afiskon/hbr-3b/images/hbr-3b-transceiver.jpg

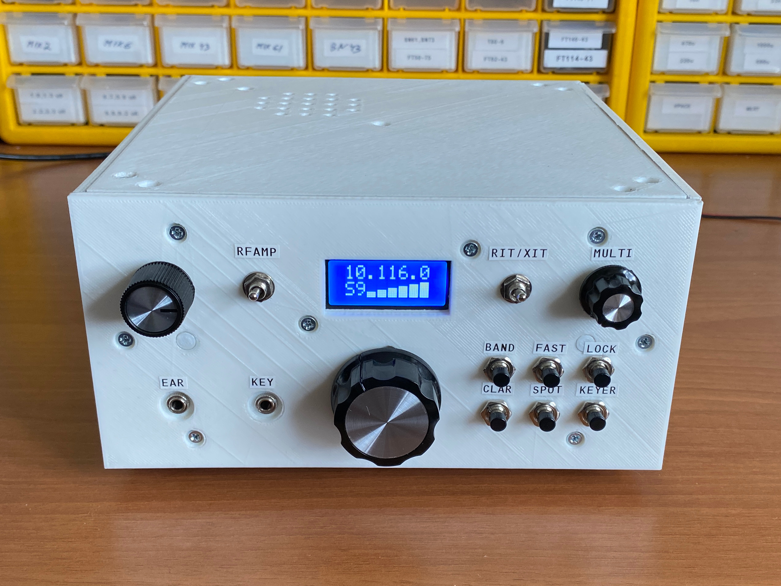
images/hbr-3b-transceiver.jpg
