afiskon/hbr-3b/README.md

# HBR/3B

QRP CW Transceiver

* Covers 30, 17, and 12 meters
* Easily modifiable for other 3 bands or [all 8 HF bands](https://github.com/afiskon/hbr-8b)
* Classical single IF superheterodyne design
* Free of spurious signals!
* Simple but effective AGC
* Supports RIT and XIT
* 10-30 WPM Elekey-B type keyer + straight key mode
* Keyer settings are saved in EEPROM
* ~5W class C power amplifier
* Has a S-meter and a SWR meter
* Open-source firmware, schematic and 3D-printable enclosure

Links

* Article (in Russian): https://eax.me/2022/2022-09-05-hbr-3b-transceiver.html
* Demo: https://www.youtube.com/watch?v=xab1Q_SXZec
