afiskon/hbr-3b/firmware/si5351/README.md

# stm32-si5351

HAL-based Si5351 driver for STM32.

Main respository: https://github.com/afiskon/stm32-si5351
