afiskon/hbr-3b/images/filters/bpf-12m.png

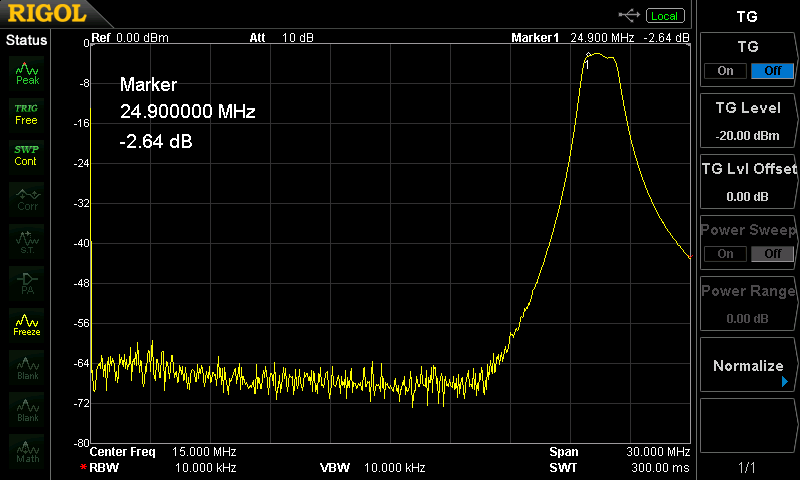
images/filters/bpf-12m.png
