afiskon/hbr-3b/images/filters/bpf-17m.png

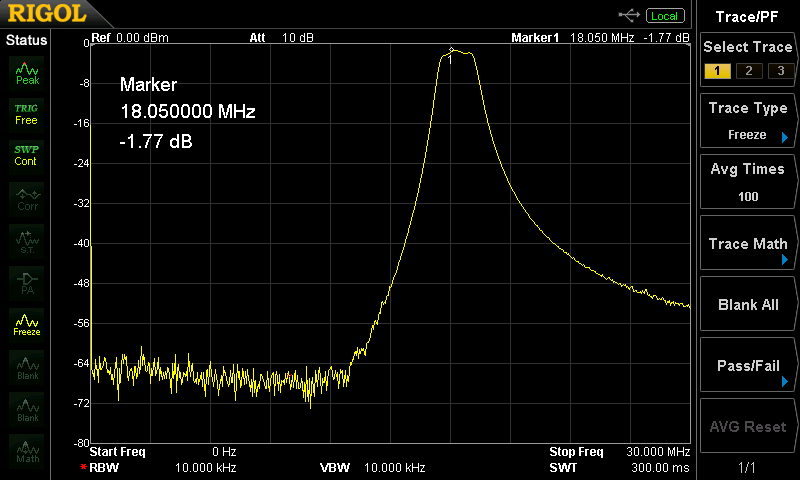
images/filters/bpf-17m.png
