afiskon/hbr-3b/images/filters/bpf-30m.png

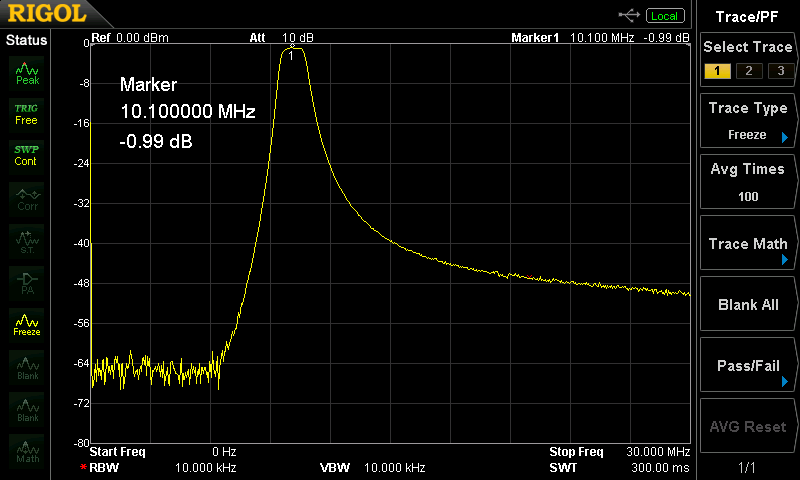
images/filters/bpf-30m.png
