afiskon/hbr-3b/images/filters/lpf-9mhz.png

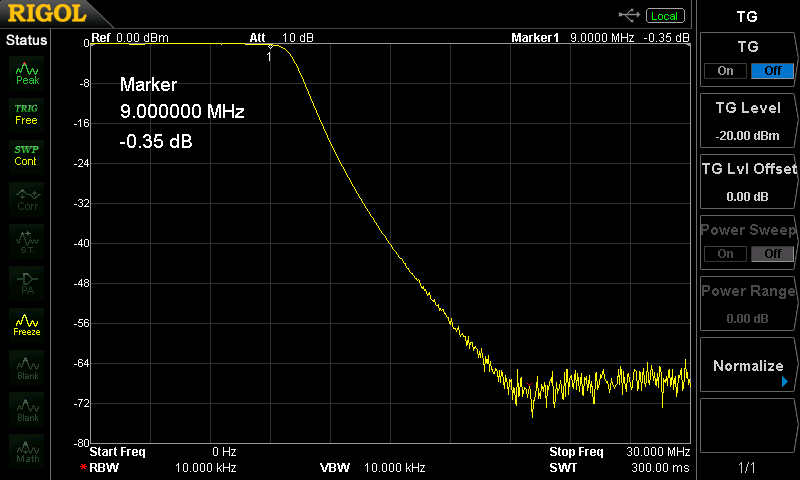
images/filters/lpf-9mhz.png
