afiskon/hbr-3b/images/filters/lpf-12m.png

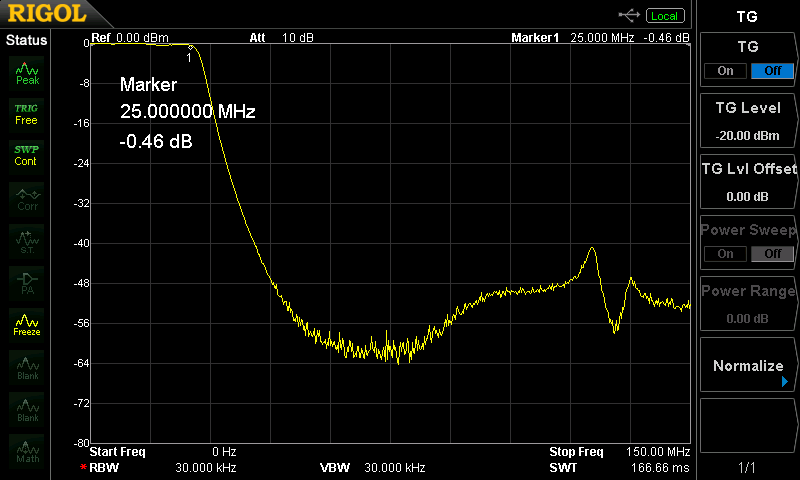
images/filters/lpf-12m.png
