afiskon/hbr-3b/images/filters/lpf-17m.png

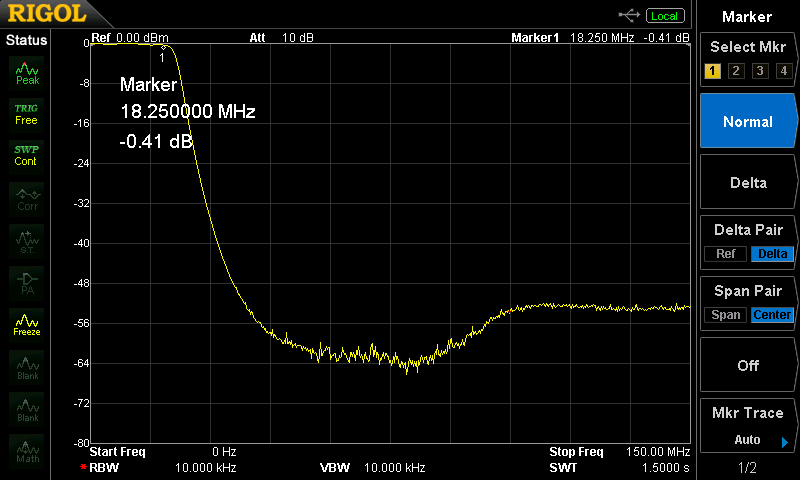
images/filters/lpf-17m.png
