afiskon/hbr-3b/images/filters/lpf-30m.png

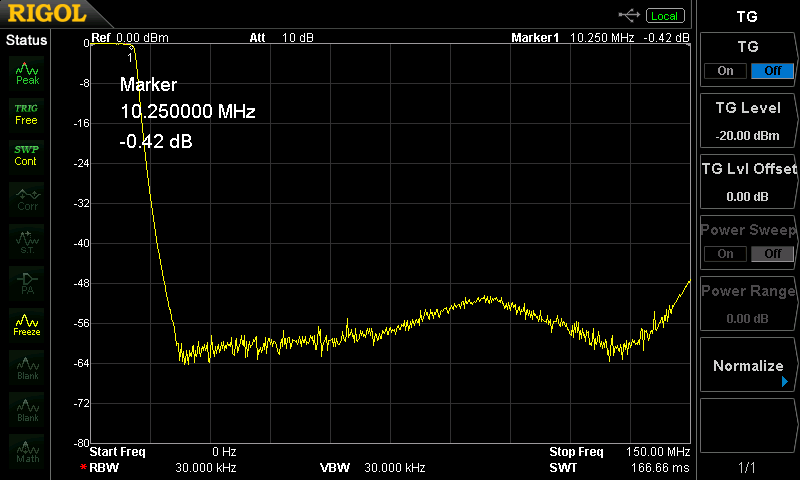
images/filters/lpf-30m.png
