afiskon/hbr-3b/images/si5351-vs-ad9850/ad9850-block-diagram.png

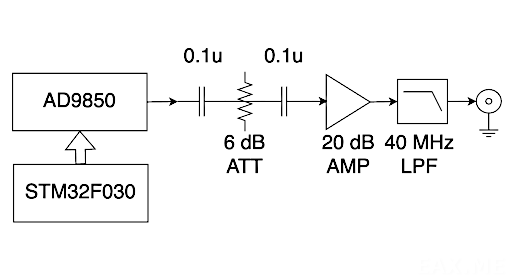
images/si5351-vs-ad9850/ad9850-block-diagram.png
