afiskon/hbr-3b/images/si5351-vs-ad9850/si5351-spectrum.png

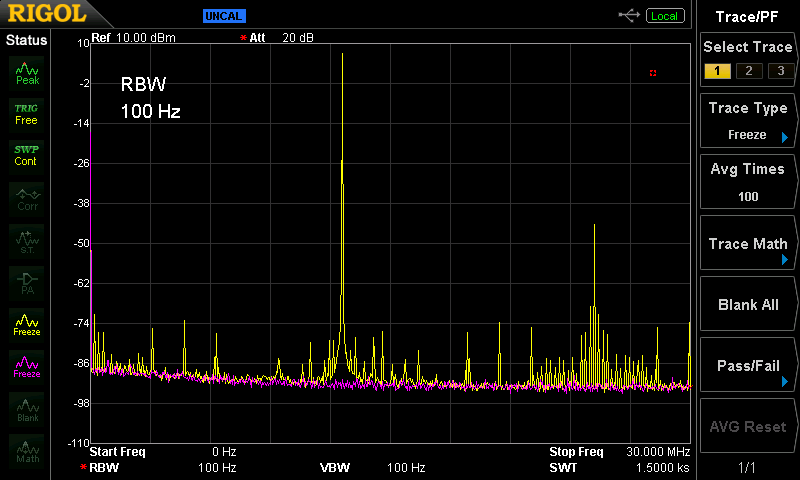
images/si5351-vs-ad9850/si5351-spectrum.png
