afiskon/hbr-3b/images/signal/signal-12m.png

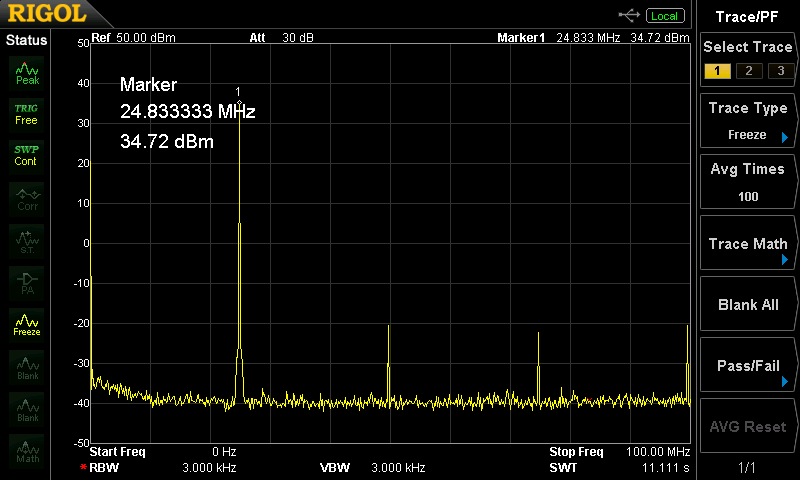
images/signal/signal-12m.png
