afiskon/hbr-3b/images/signal/signal-17m.png

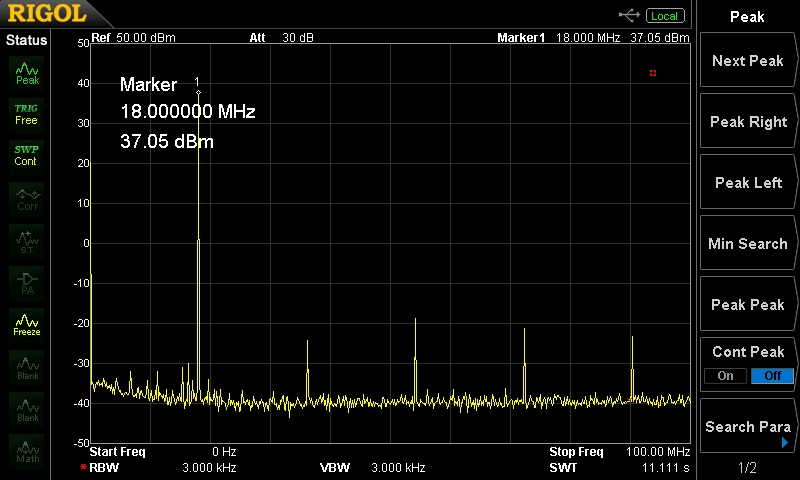
images/signal/signal-17m.png
