afiskon/hbr-3b/images/signal/signal-30m.png

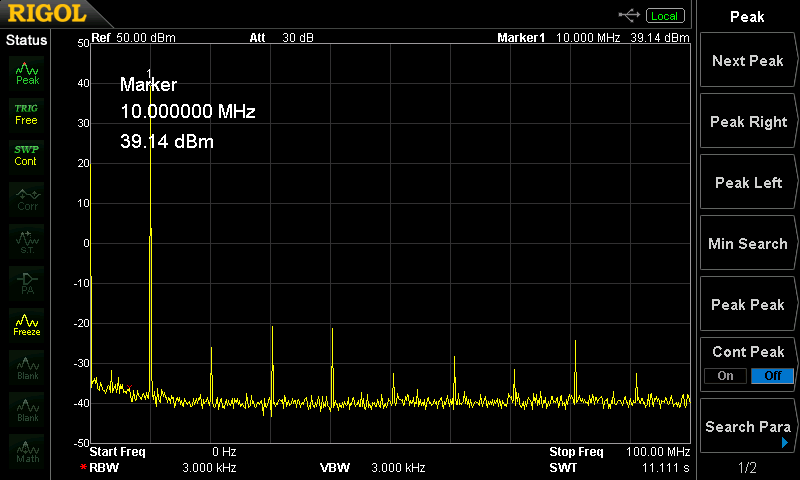
images/signal/signal-30m.png
