afiskon/hbr-3b/enclosure/large-angle.stl

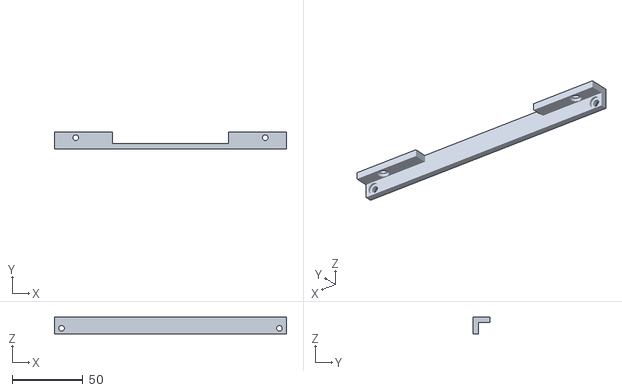
[picture p15: CAD file, 2022-07-16]
enclosure/large-angle.stl
164.0 x 12.0 x 12.0
