afiskon/hbr-3b/enclosure/top.stl

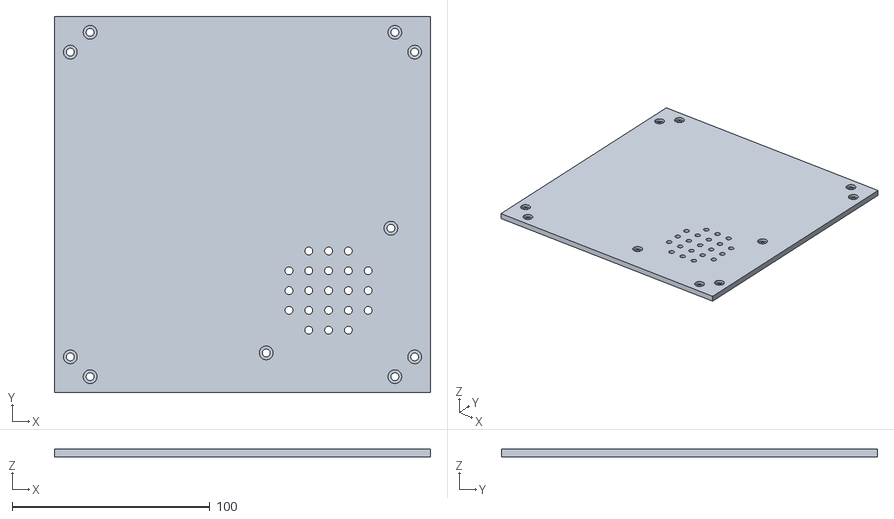
[picture p16: CAD file, 2022-07-16]
enclosure/top.stl
190.0 x 190.0 x 4.00
