afiskon/hbr-3b/enclosure/small-angle.stl

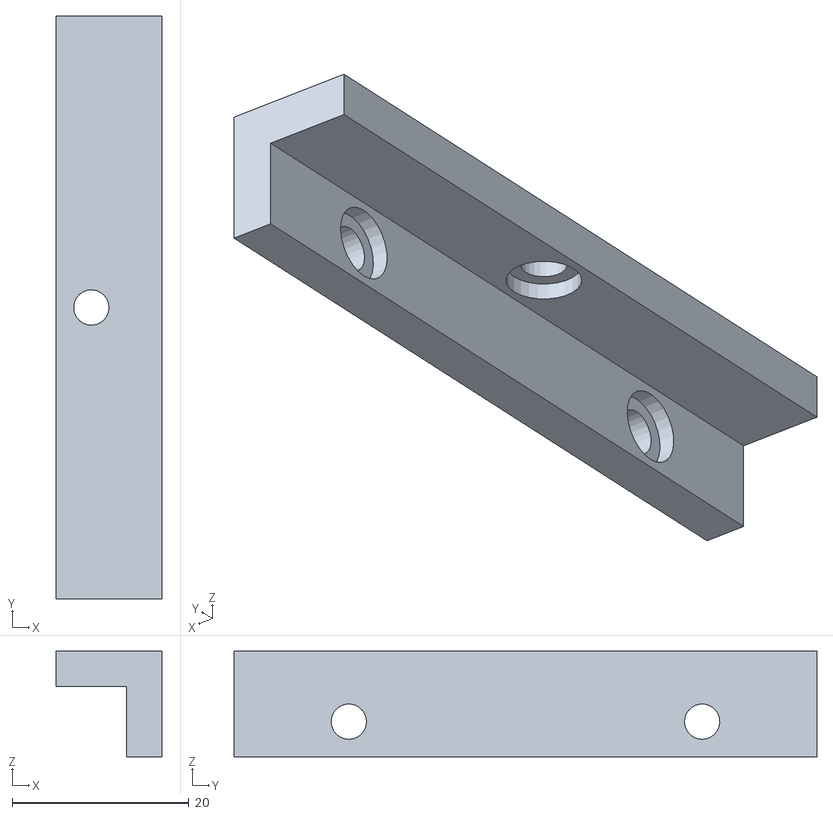
[picture p17: CAD file, 2022-07-16]
enclosure/small-angle.stl
12.0 x 66.0 x 12.0
