afiskon/hbr-3b/enclosure/back.stl

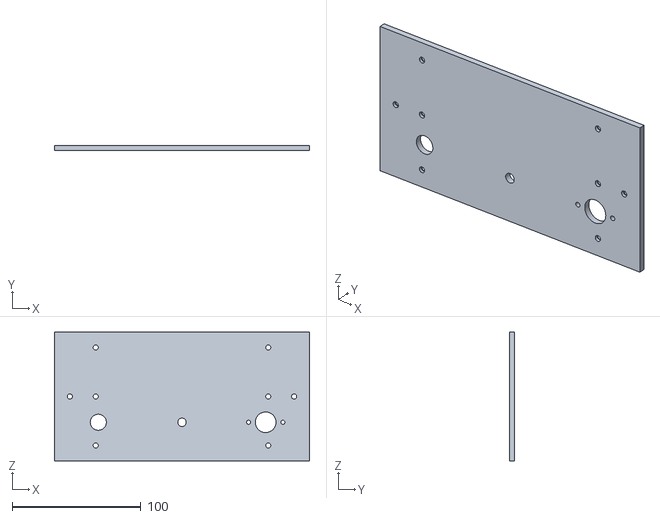
[picture p18: CAD file, 2022-07-16]
enclosure/back.stl
198.0 x 4.00 x 100.0
