afiskon/hbr-3b/enclosure/front.stl

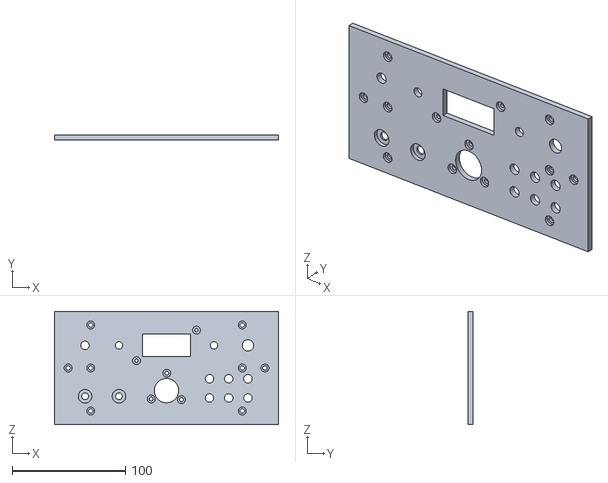
[picture p19: CAD file, 2022-07-16]
enclosure/front.stl
198.0 x 4.00 x 100.0
