afiskon/hbr-3b/enclosure/side.stl

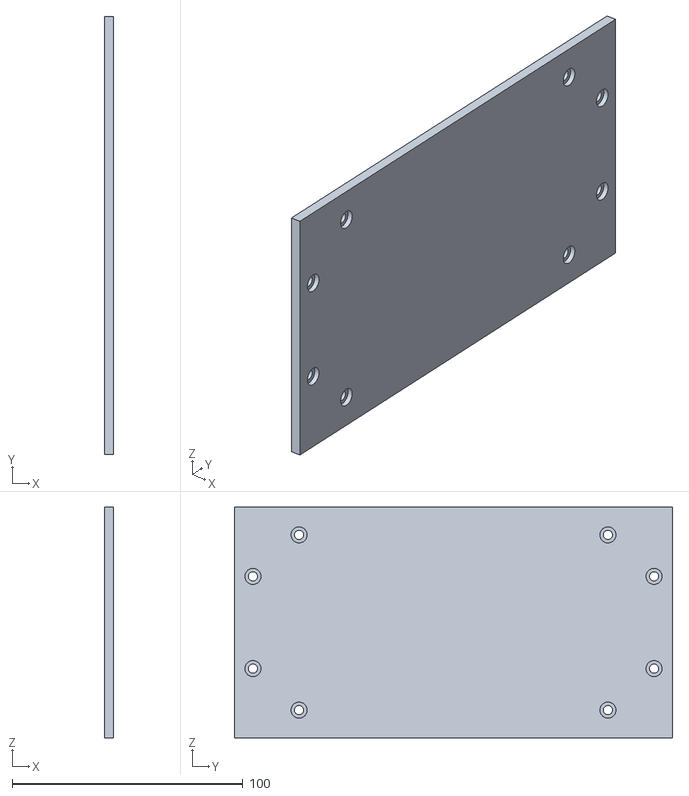
[picture p20: CAD file, 2022-07-16]
enclosure/side.stl
4.00 x 190.0 x 100.0
