afiskon/hbr-3b/enclosure/screw-cap.stl

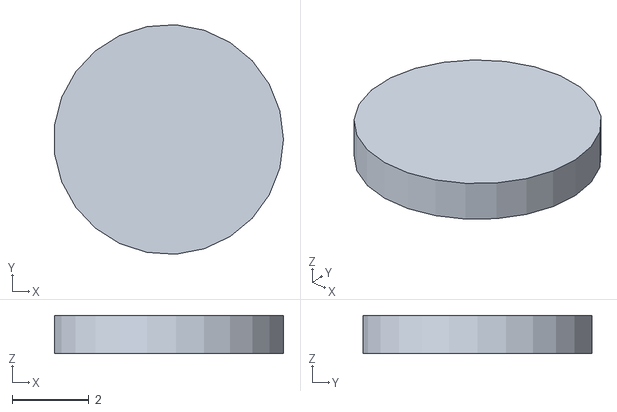
[picture p21: CAD file, 2022-07-16]
enclosure/screw-cap.stl
5.98 x 5.99 x 1.00
