afiskon/hbr-3b/(list of files, cad)

Other CAD files:
enclosure/bottom.stl
enclosure/enclosure.scad
enclosure/screw-cap.scad
