afiskon/hbr-3b/schematic/hbr-3b-schematic.pdf

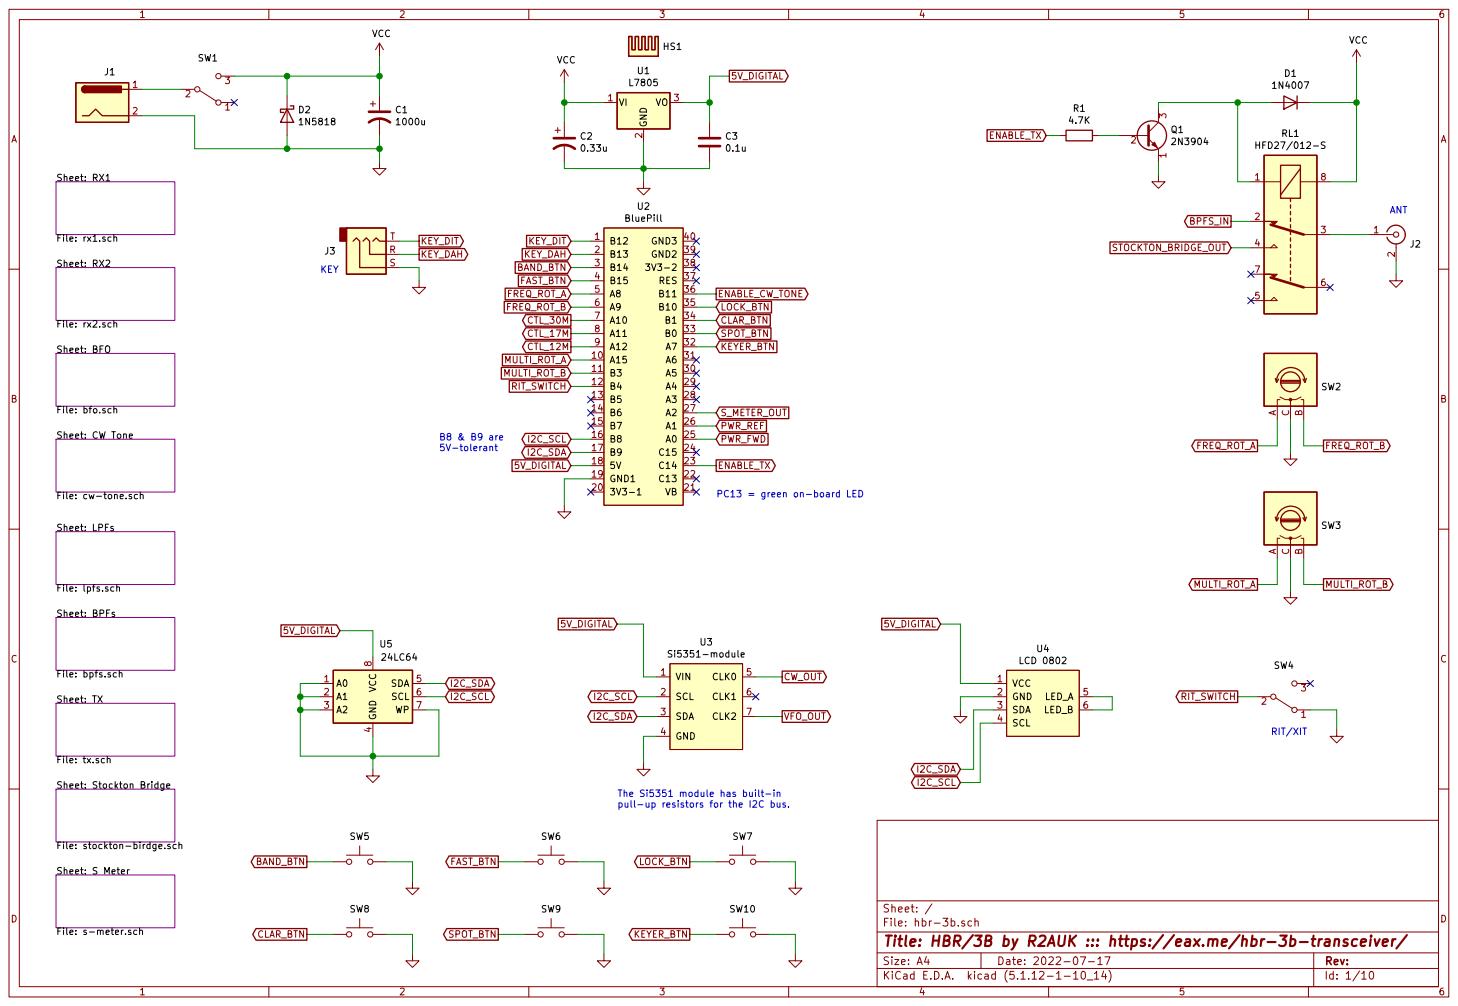
[picture p22: page 1]

Sheet: RX1 File: rx1.sch Sheet: RX2 File: rx2.sch Sheet: BFO

RIT/XIT B8 & B9 are 5V-tolerant KEY

File: bfo.sch Sheet: CW Tone File: cw-tone.sch Sheet: TX

PC13 = green on-board LED

Id: 1/10 Title: HBR/3B by R2AUK ::: https://eax.me/hbr-3b-transceiver/ File: hbr-3b.sch Sheet: / Sheet: LPFs File: lpfs.sch Sheet: BPFs File: bpfs.sch

4 SDA 5 SCL 6 WP 7 VCC

File: tx.sch Sheet: Stockton Bridge

The Si5351 module has built-in
pull-up resistors for the I2C bus.

File: stockton-birdge.sch Sheet: S Meter File: s-meter.sch

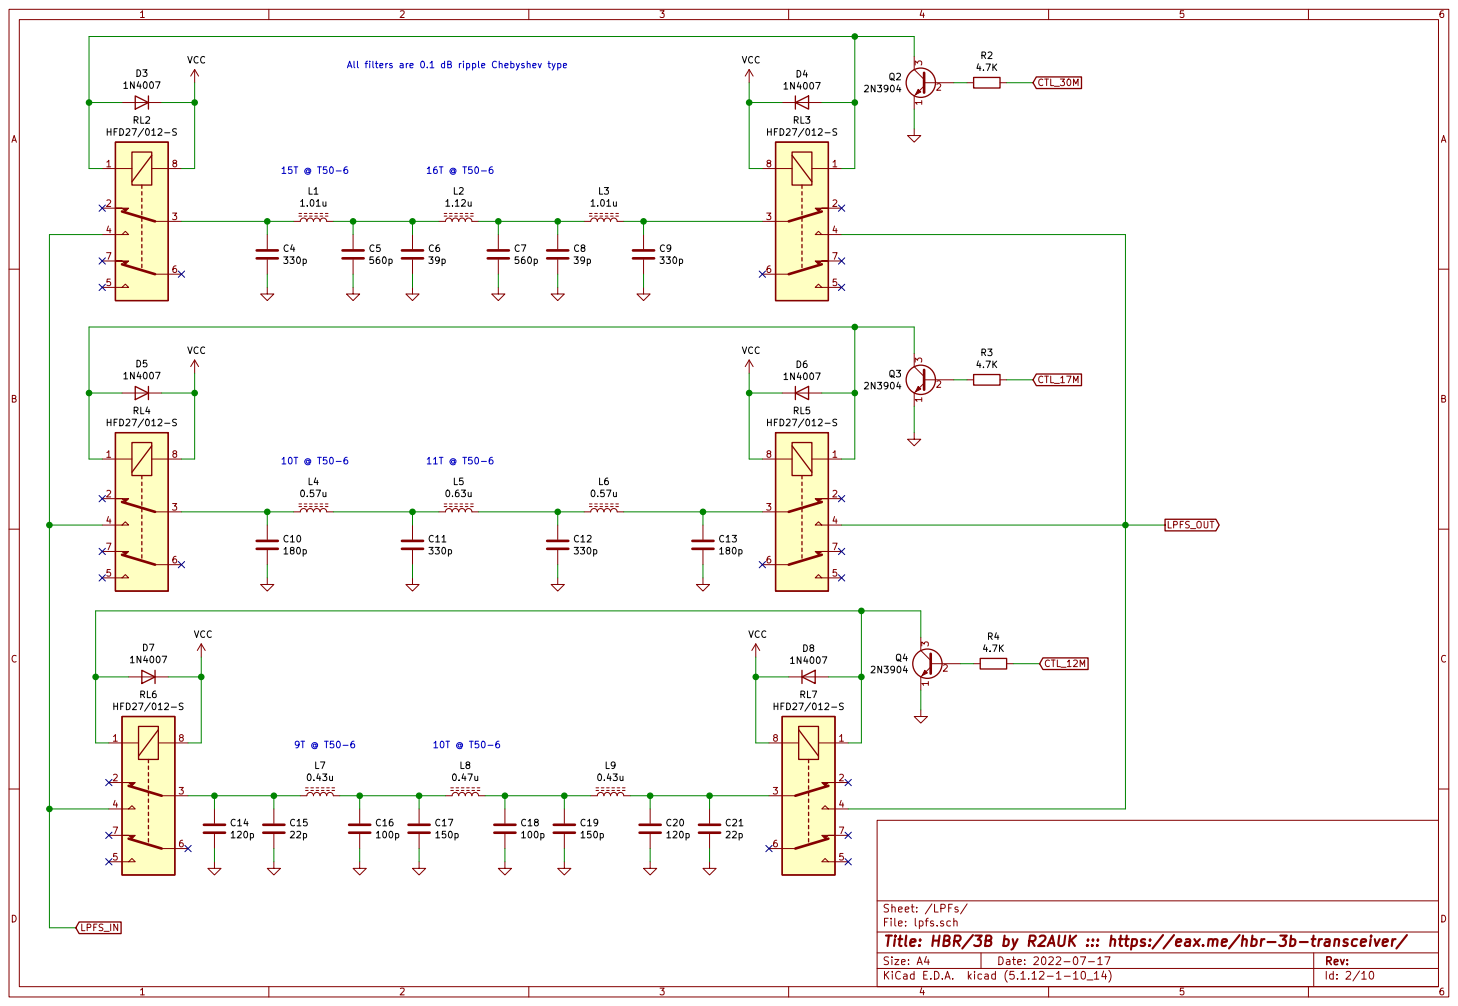
[picture p23: page 2]

All filters are 0.1 dB ripple Chebyshev type

File: lpfs.sch Sheet: /LPFs/ 1

Id: 2/10 Title: HBR/3B by R2AUK ::: https://eax.me/hbr-3b-transceiver/

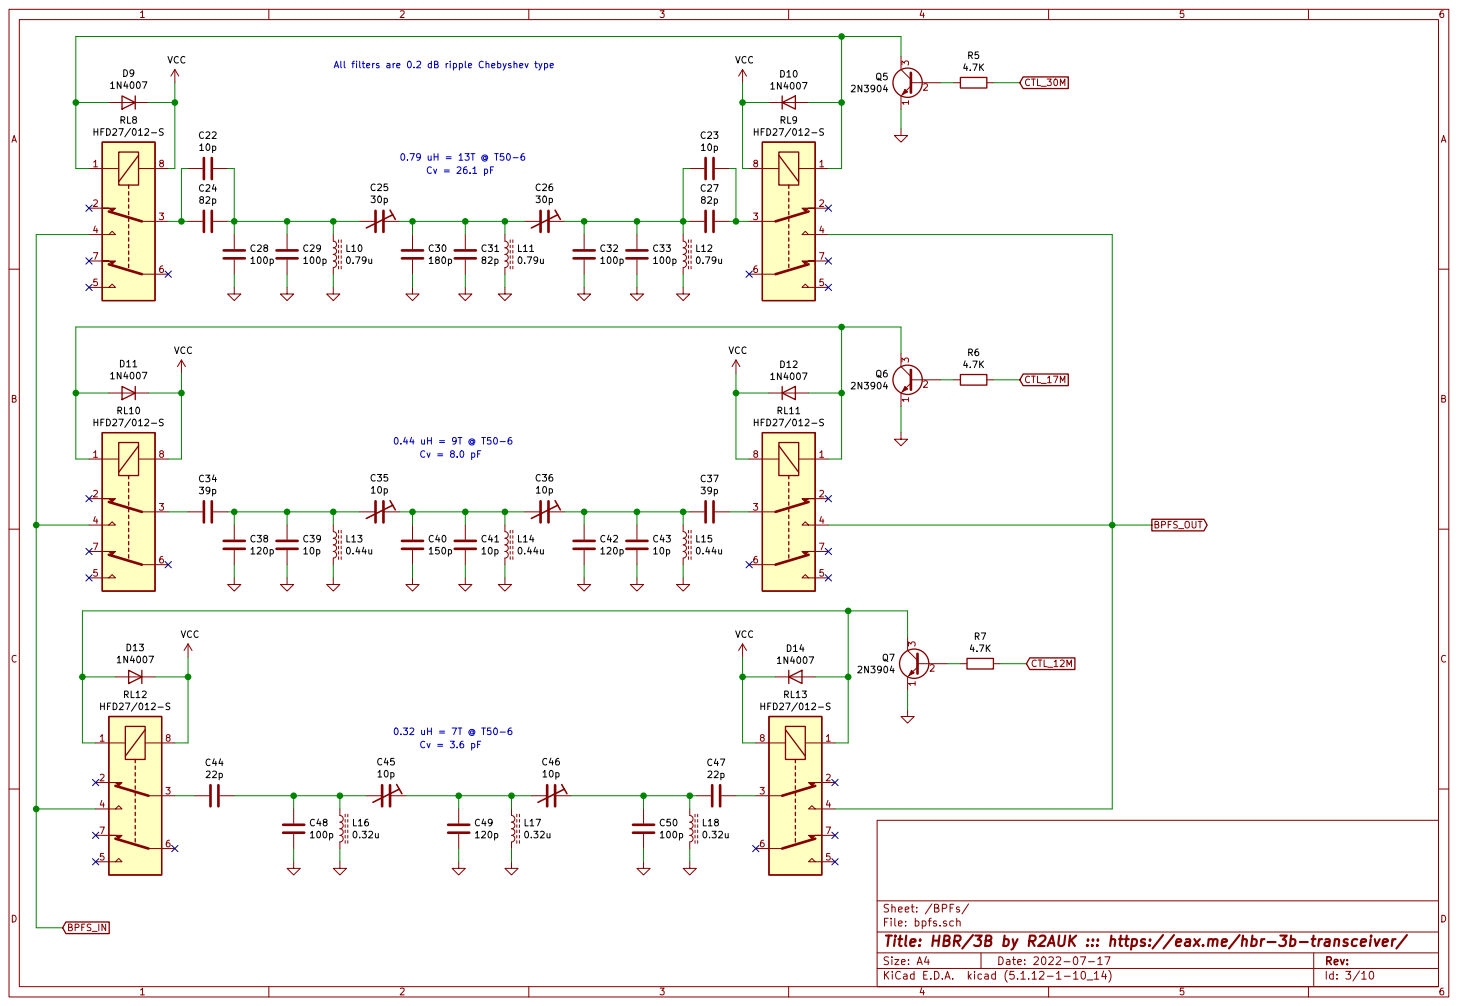
[picture p24: page 3]

0.44 uH = 9T @ T50-6 All filters are 0.2 dB ripple Chebyshev type

File: bpfs.sch Sheet: /BPFs/ 1

Id: 3/10 Title: HBR/3B by R2AUK ::: https://eax.me/hbr-3b-transceiver/

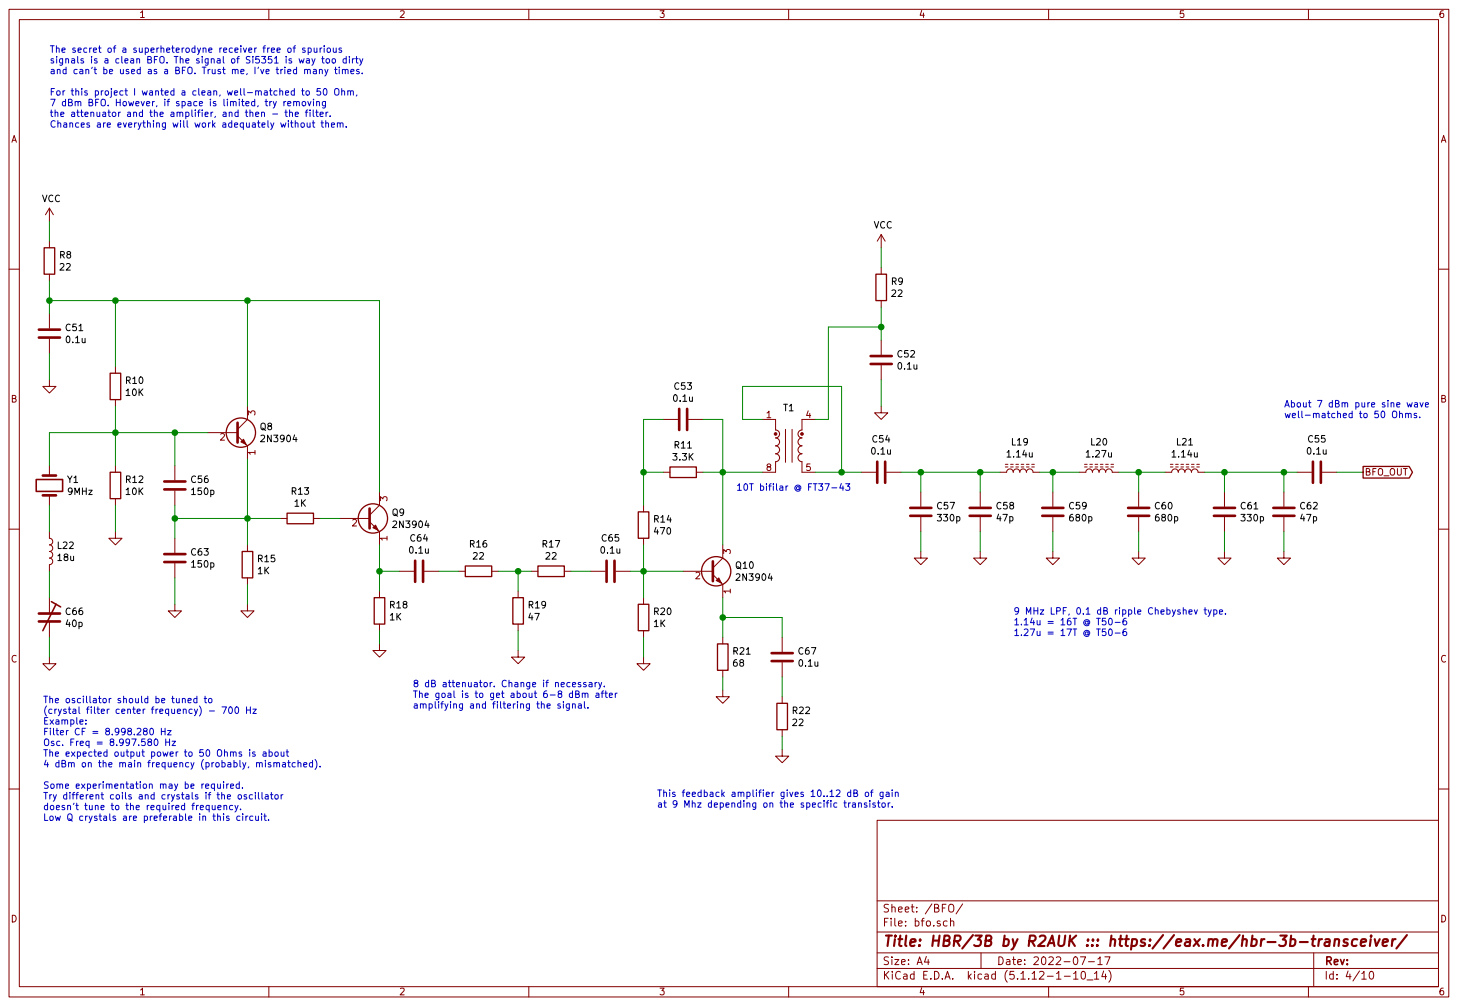
[picture p25: page 4]

signals is a clean BFO. The signal of Si5351 is way too dirty
and cant be used as a BFO. Trust me, Ive tried many times.

For this project I wanted a clean, well-matched to 50 Ohm,
7 dBm BFO. However, if space is limited, try removing
the attenuator and the amplifier, and then - the filter.
Chances are everything will work adequately without them.

10T bifilar @ FT37-43 This feedback amplifier gives 10..12 dB of gain

9 MHz LPF, 0.1 dB ripple Chebyshev type. 1.14u = 16T @ T50-6

8 dB attenuator. Change if necessary.
The goal is to get about 6-8 dBm after
amplifying and filtering the signal.

at 9 Mhz depending on the specific transistor. The oscillator should be tuned to
(crystal filter center frequency) - 700 Hz
Example: Filter CF = 8.998.280 Hz Osc. Freq = 8.997.580 Hz

The expected output power to 50 Ohms is about
4 dBm on the main frequency (probably, mismatched).

Some experimentation may be required.
Try different coils and crystals if the oscillator
doesnt tune to the required frequency.
Low Q crystals are preferable in this circuit.

Id: 4/10 Title: HBR/3B by R2AUK ::: https://eax.me/hbr-3b-transceiver/ File: bfo.sch Sheet: /BFO/

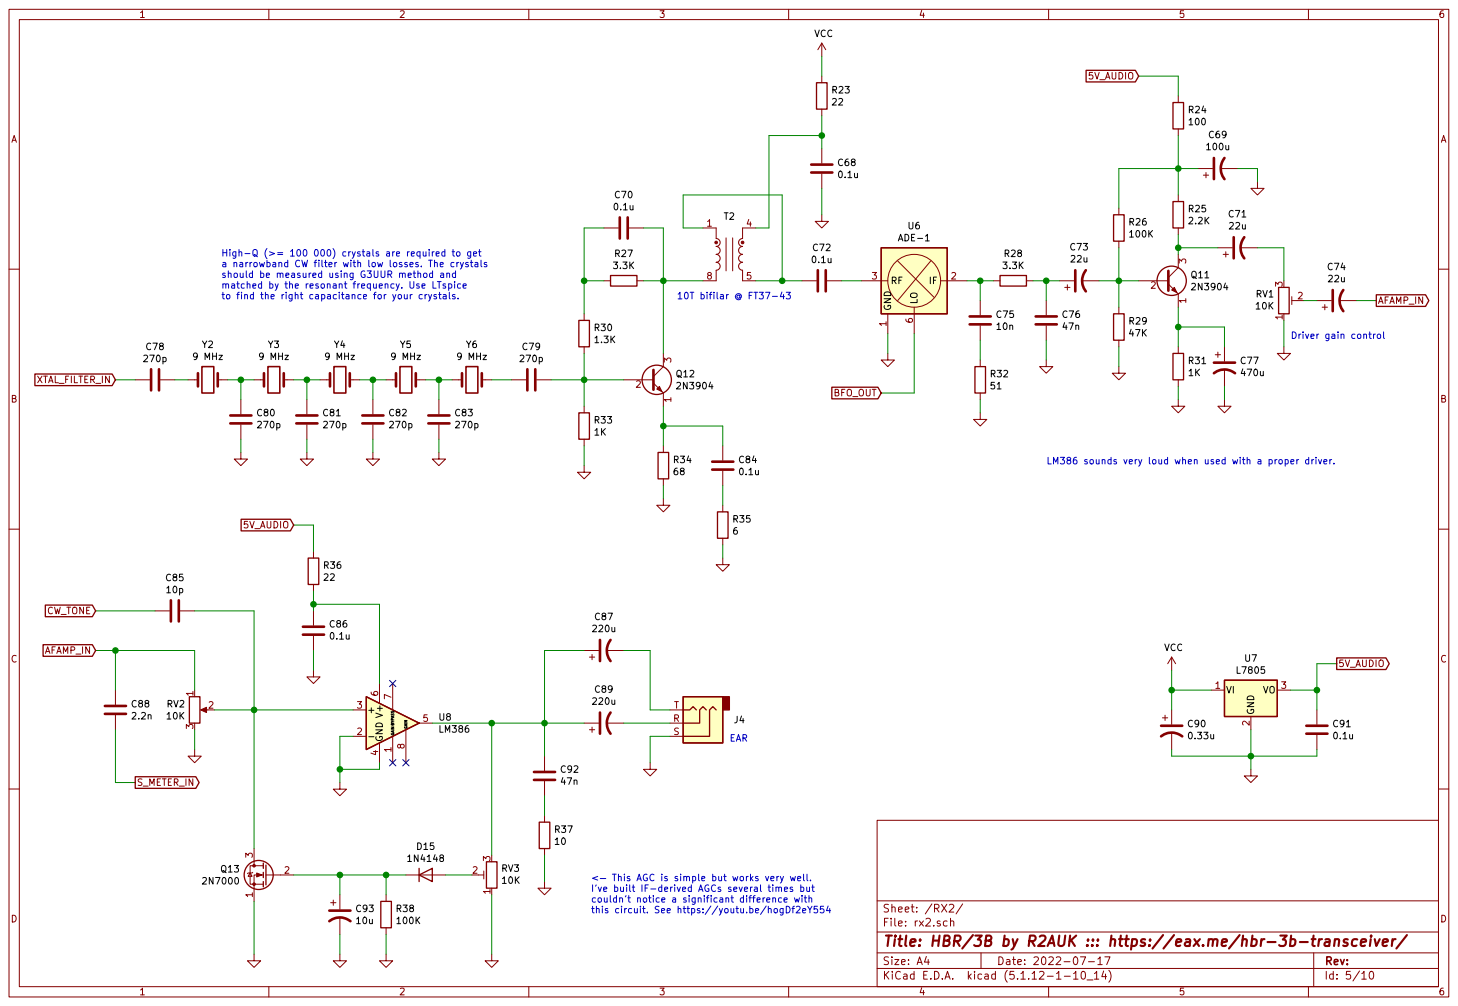
[picture p26: page 5]

High-Q (>= 100 000) crystals are required to get
a narrowband CW filter with low losses. The crystals
should be measured using G3UUR method and
matched by the resonant frequency. Use LTspice

LM386 sounds very loud when used with a proper driver.

< This AGC is simple but works very well.
Ive built IF-derived AGCs several times but couldnt notice a significant difference with

Id: 5/10 Title: HBR/3B by R2AUK ::: https://eax.me/hbr-3b-transceiver/ File: rx2.sch Sheet: /RX2/

this circuit. See https://youtu.be/hogDf2eY554

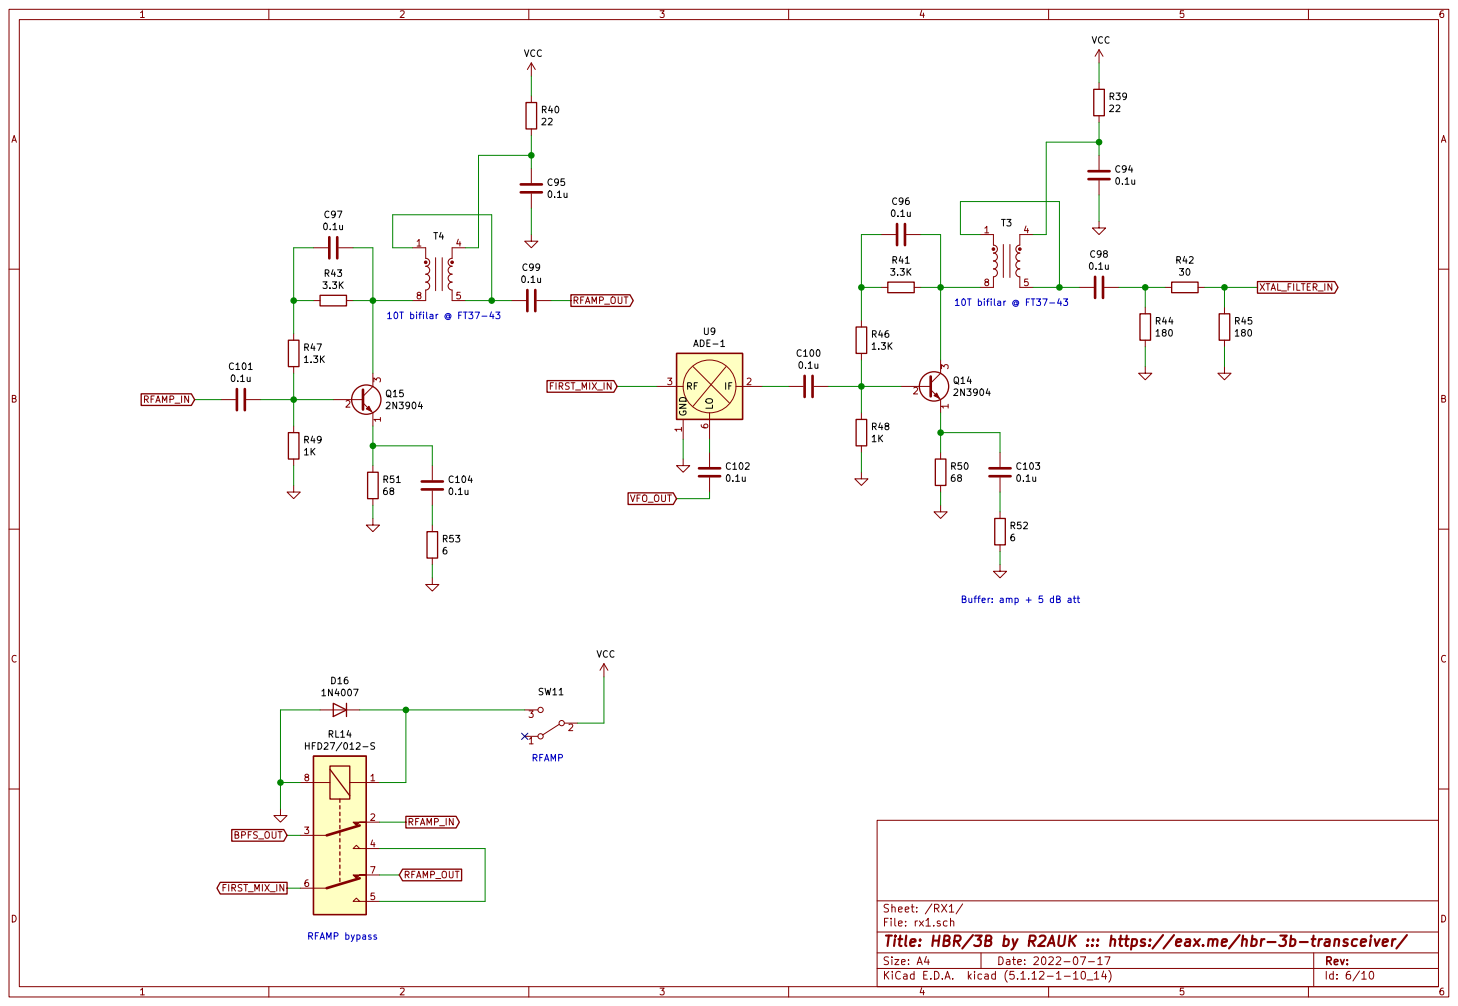
[picture p27: page 6]

Buffer: amp + 5 dB att RFAMP

Id: 6/10 Title: HBR/3B by R2AUK ::: https://eax.me/hbr-3b-transceiver/ File: rx1.sch Sheet: /RX1/

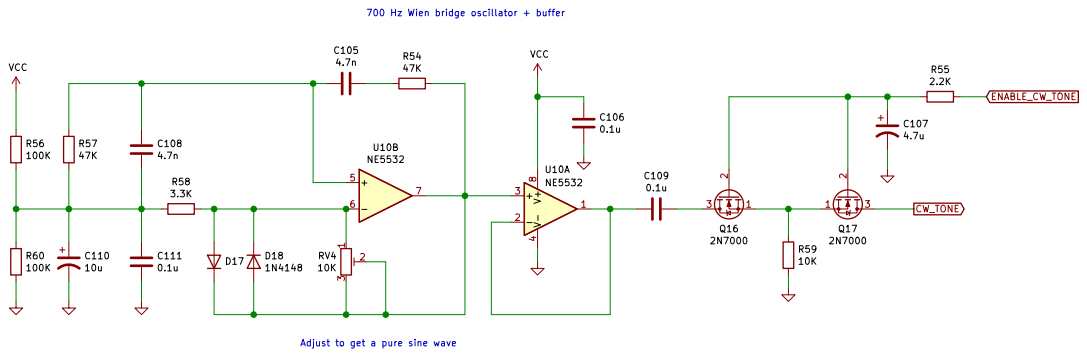
[picture p28: page 7]

700 Hz Wien bridge oscillator + buffer

Adjust to get a pure sine wave

Id: 7/10 Title: HBR/3B by R2AUK ::: https://eax.me/hbr-3b-transceiver/ File: cw-tone.sch Sheet: /CW Tone/

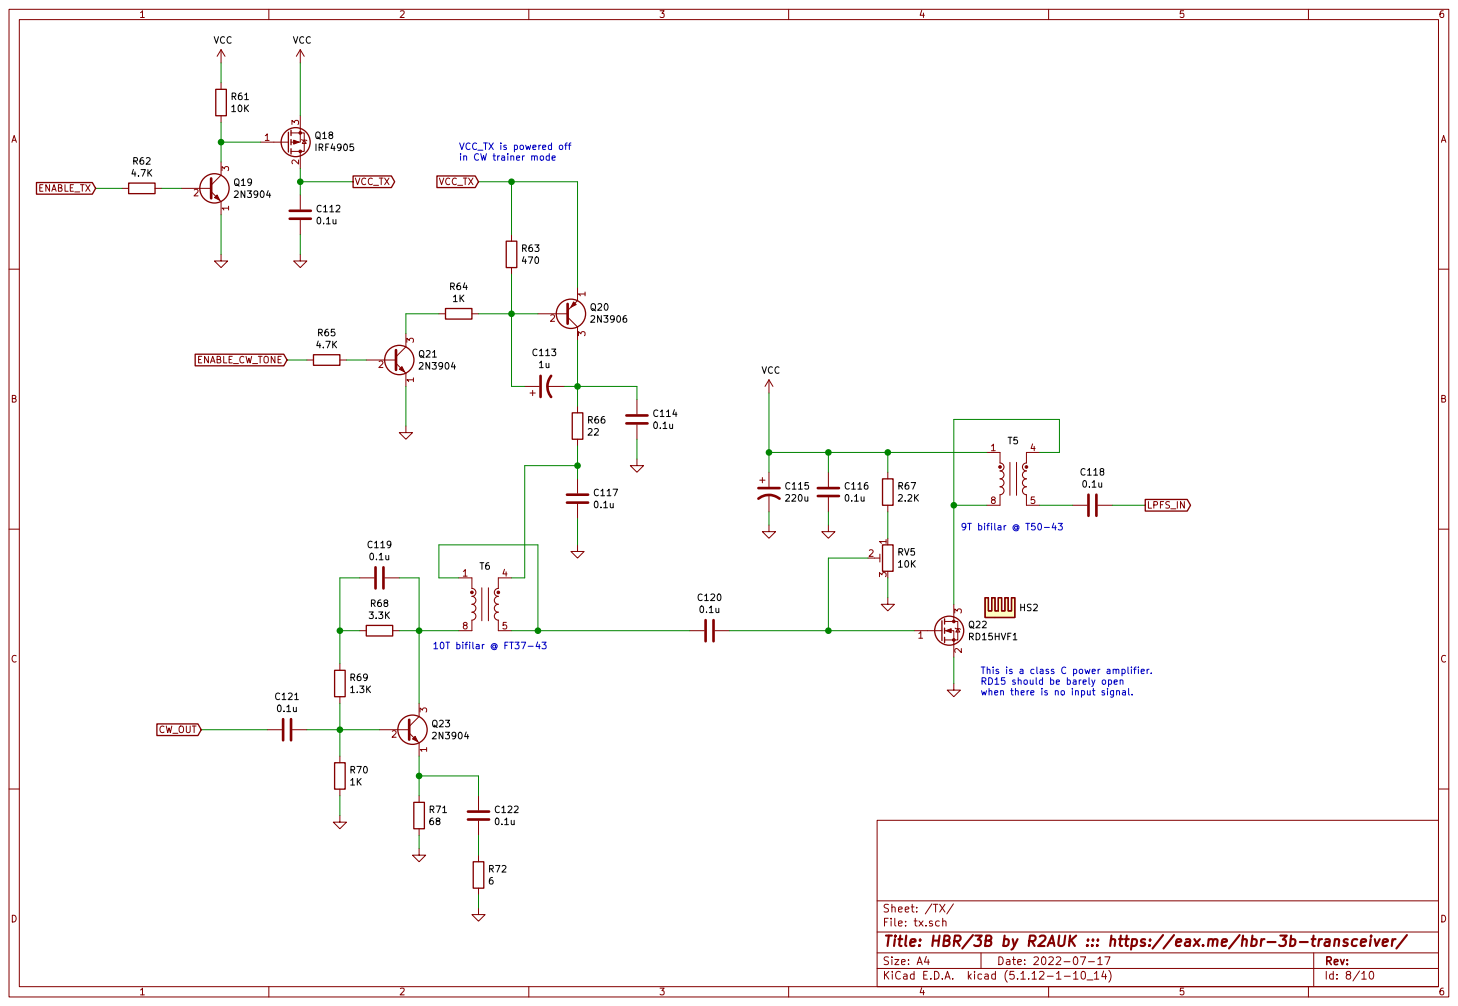
[picture p29: page 8]

RD15 should be barely open
when there is no input signal.

Id: 8/10 Title: HBR/3B by R2AUK ::: https://eax.me/hbr-3b-transceiver/ File: tx.sch Sheet: /TX/

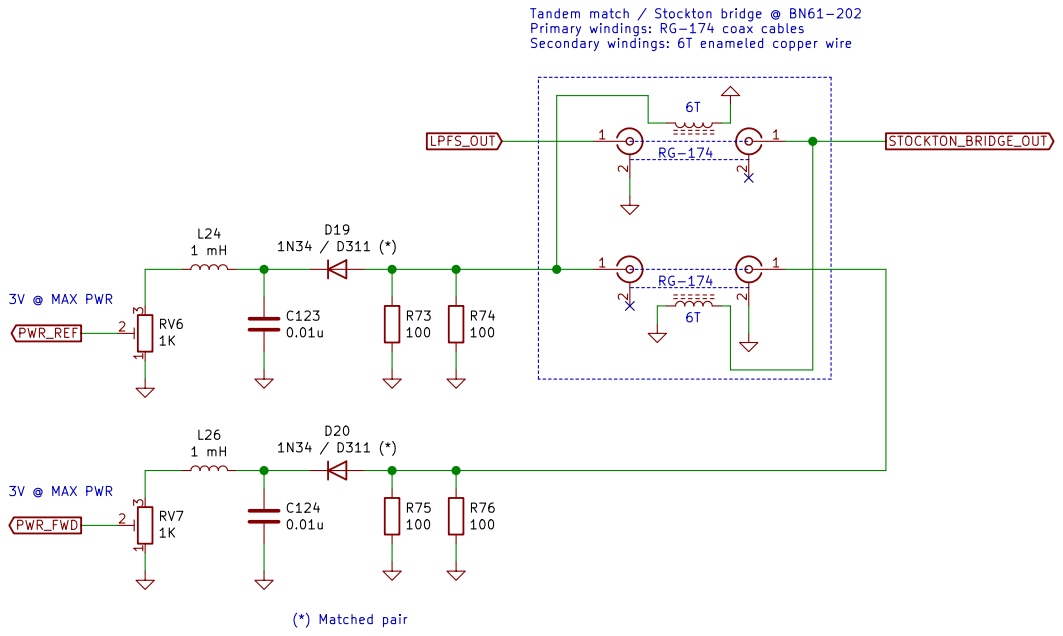
[picture p30: page 9]

Tandem match / Stockton bridge @ BN61-202
Primary windings: RG-174 coax cables
Secondary windings: 6T enameled copper wire

Sheet: /Stockton Bridge/
File: stockton-birdge.sch
Id: 9/10 Title: HBR/3B by R2AUK ::: https://eax.me/hbr-3b-transceiver/

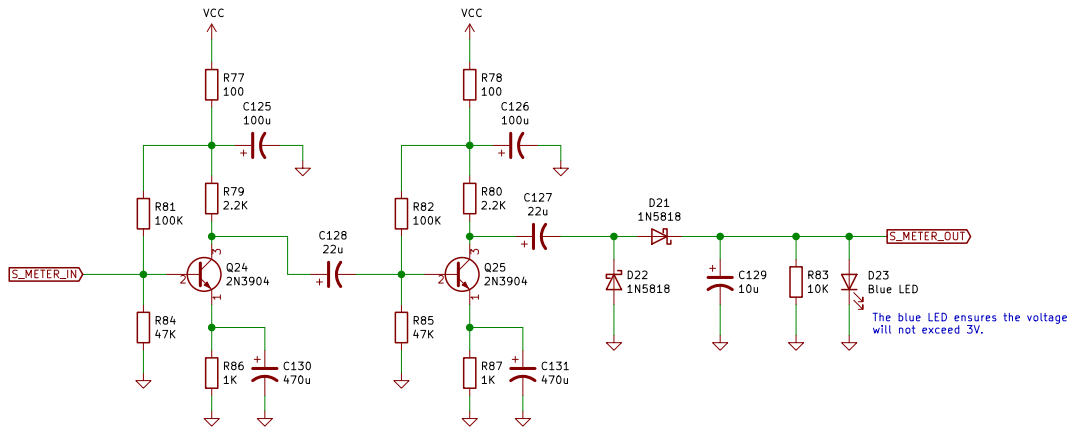
[picture p31: page 10]

The blue LED ensures the voltage will not exceed 3V.

Id: 10/10 Title: HBR/3B by R2AUK ::: https://eax.me/hbr-3b-transceiver/ File: s-meter.sch Sheet: /S Meter/
