afiskon/hbr-3b/schematic/hbr-3b.kicad_pcb

## KiCad design ndp2019-wristband-schematic/ndp2019-wristband-schematic.sch

Schematic: ndp2019-wristband-schematic.sch

Parts:
C1, C2: C
D1: DIODE
IR1: IR
LED1, LED2: LED_BRG
R1: 1200
U1: MC81F4104
U2: AT24C02S; SOT-23-5

Notes on the sheet:
Vdd and Vss pins might be wrong
