afiskon/hbr-3b/(commit log)

2022-07-16 Move KiCAD project from a sandbox repository
    [bfo.sch, bpfs.sch, cw-tone.sch, hbr-3b.kicad_pcb, hbr-3b.sch, lpfs.sch, rx1.sch, rx2.sch]
2022-07-16 Move OpenSCAD project from a sandbox repository
    [back.stl, bottom.stl, enclosure.scad, front.stl, large-angle.stl, screw-cap.scad, screw-cap.stl, side.stl]
2022-07-17 Move images/{lpf,bpf}-*.png to images/filters/
2022-07-17 Fix typo: PWR_FED -> PWR_FWD
    [stockton-birdge.sch]
2022-07-17 Fix typo: 400u -> 470u
    [rx2.sch, s-meter.sch]
2022-08-16 Some minor tweaks
    [cw-tone.sch, rx2.sch, s-meter.sch]
2022-12-16 Remove images/interals-*.jpg
    I've found several mistakes in the circuit so these pictures are just wrong.
    Additionally they duplicate the content of the article (where pictures are
    too small to see much details so there is no need to edit them).
2022-12-17 Correct the schematic
    [cw-tone.sch, rx1.sch, rx2.sch, s-meter.sch, stockton-birdge.sch, tx.sch]
2022-12-17 Update the firmware according to the recent corrections in the schematic
    [main.c]
