afiskon/hbr-3b/(notices)

Notices in the files:
firmware/Src/main.c:
COPYRIGHT(c) 2020 STMicroelectronics
(C) COPYRIGHT STMicroelectronics *****END OF FILE
